cmrnfaith/Text2Speech/Concept.png

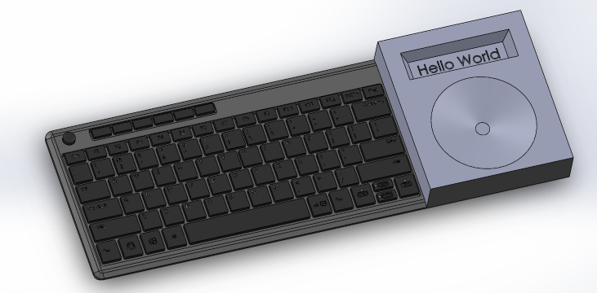
Concept.png
