cmrnfaith/Text2Speech/README.md

# Text2Speech
A repository for my ENEL 300 Final Design Project
