cmrnfaith/Text2Speech/0001.jpg

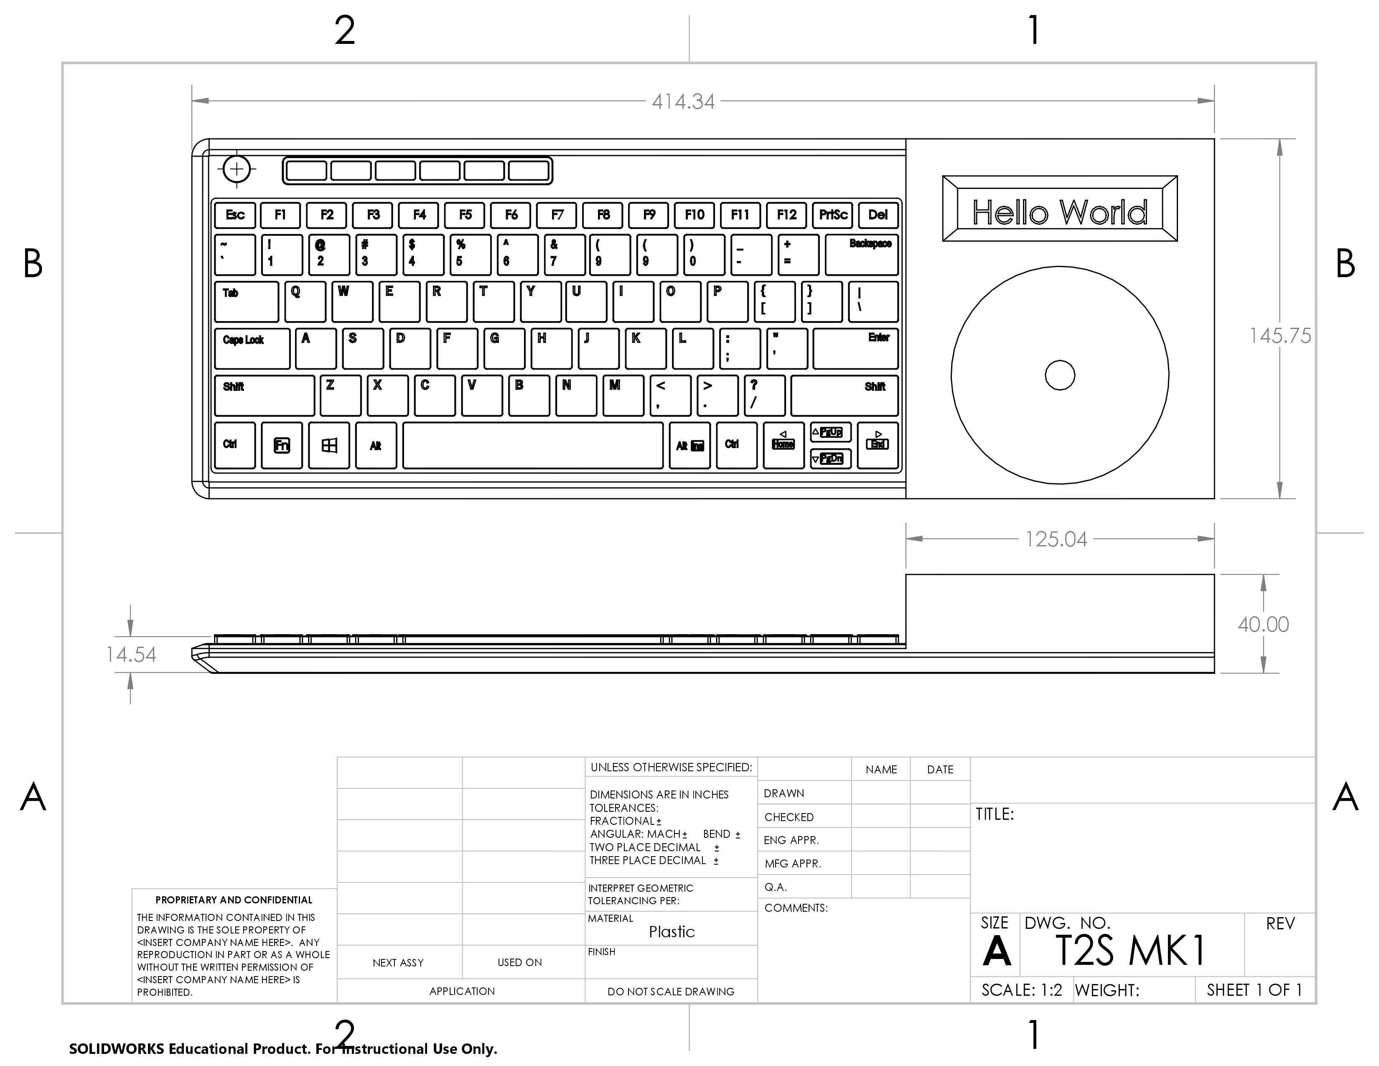
0001.jpg
